mlmdc/Flexion-XS/3_Conception_Mécanique/0_LISEZ_MOI.md

# Conception mécanique

Ce répertoire contient :

* /"Impression 3D" contient les fichiers .stl réalisés, par exemple le support d'acceleromètre.

* /"LETTRE 7 ET 8" contient les .CATPart (sans assemblage) des lettres 7 & 8 utilisées pour le nouveau balisage.

* / a l'assemblage de la maquette ainsi que les parties utilisées. En parallèle, la caractérisation du moteur et de son filtre est donné.

Un pdf d'explications vis-à-vis du procédé de conception est donné.
