mlmdc/Flexion-XS/2_Conception_électronique/0_LISEZ_MOI.md

# Conception électronique

Ce dossier contient le travail effectué sur la conception électronique ajoutée au projet. 
Cela correspond à 2 parties :
* La remise au gout du jour et de la réalité du schéma de sécurité EDITSAB
* La conception de la carte filtre passe-bas

A ces 2 taches sont ajoutés des rapports d'activités expliquant le processus de conception.
