mlmdc/Flexion-XS/0_Documents/0_LISEZ_MOI.md

# Documents

**/Documents** contient les documents comme le tutoriel et autres. La source des documents (en .md) ainsi que les images utilisées sont aussi fournies, dans le but de pouvoir modifier les documents pendant les autres semestres.

**/Sources** contient les sources des documents de Tutoriel.pdf et Perspectives.pdf, ainsi que les images sources utilisées pour agrémenter visuellement les documents.
Si vous souhaitez produire un document, mettez vous dans ce répertoire et générez par commande les .pdf.
L'idée de séparer le produit d'arrivée de sa source est pour ne pas mélanger les travaux déjà effectués de ceux qui n'ont pas été encore effectués.
