mlmdc/Flexion-XS/4_Medias/0_LISEZ_MOI.md

# Medias

Ce répertoire contient les médias photos et vidéos qui vous permettront de vous situer et de comprendre le projet.

**/Photos**, comme son nom l'indique, est le lieu de toutes les photos. Celles-ci vont de l'illustration de diaporama à des photos de la maquette.

**/Videos** est lui pour les vidéos tutoriels.
