mlmdc/Flexion-XS/5_Post-traitements/0_LISEZ_MOI.md

### Post-traitements

**/Post-traitements** contient les notebooks de post-traitements, avec un rangement par type de mesures.
Au lieu de versionnage par git, le versionnage est fait en copiant les documents et en les modifiant.
L'objectif est de garder les précedentes modifications pour réutilisations ultérieures.
