mlmdc/Flexion-XS/0_Documents/affiche_flexion.pdf

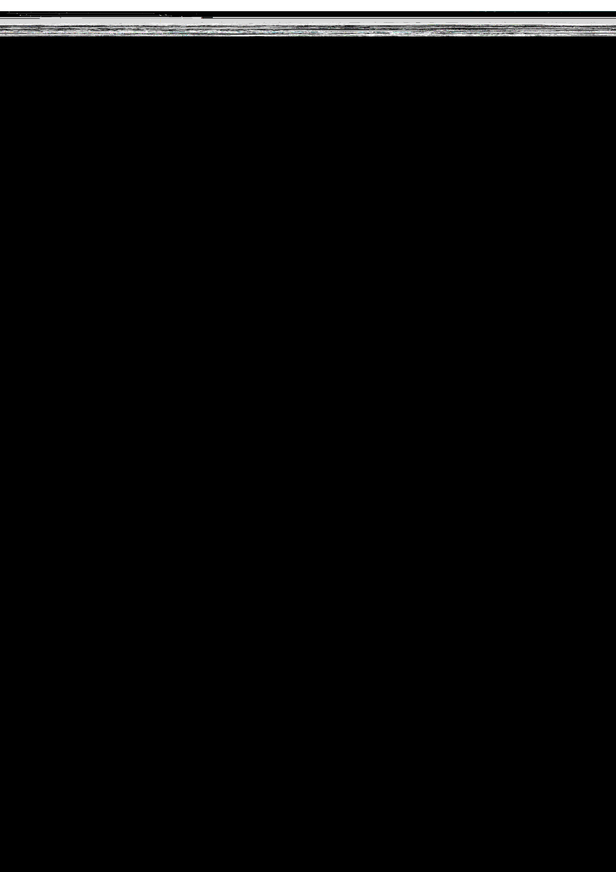
[picture p45: page 1]
