mlmdc/Flexion-XS/2_Conception_électronique/Filtre Passe-bas/Illustration exemple.PNG

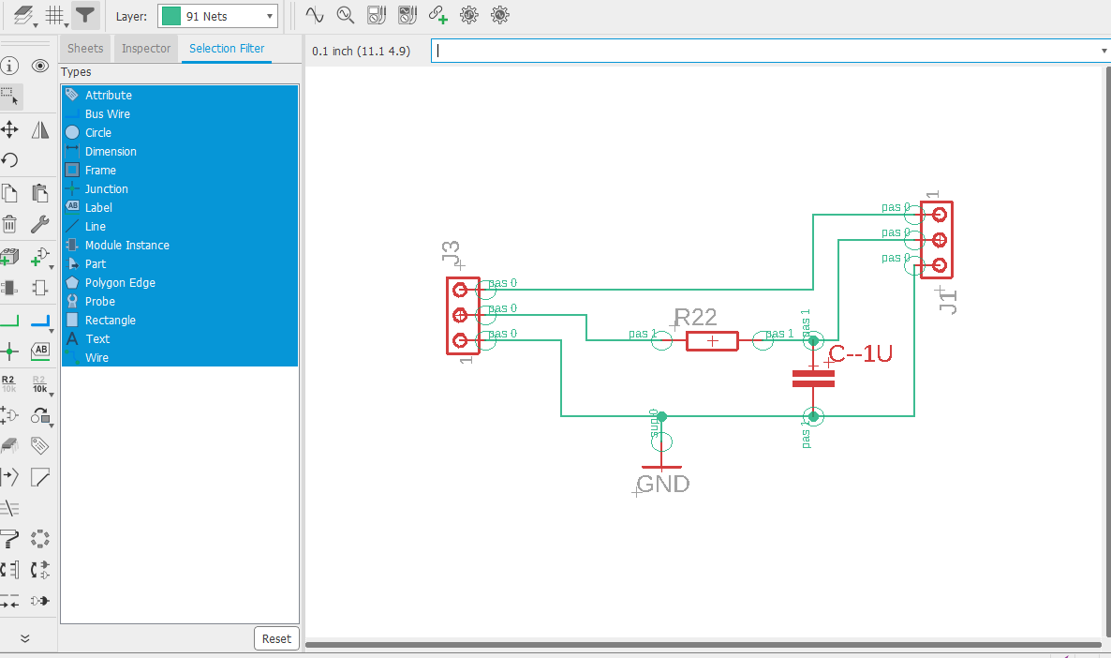
2_Conception_électronique/Filtre Passe-bas/Illustration exemple.PNG
