mlmdc/Flexion-XS/4_Medias/Photos/branchement_accel.jpg

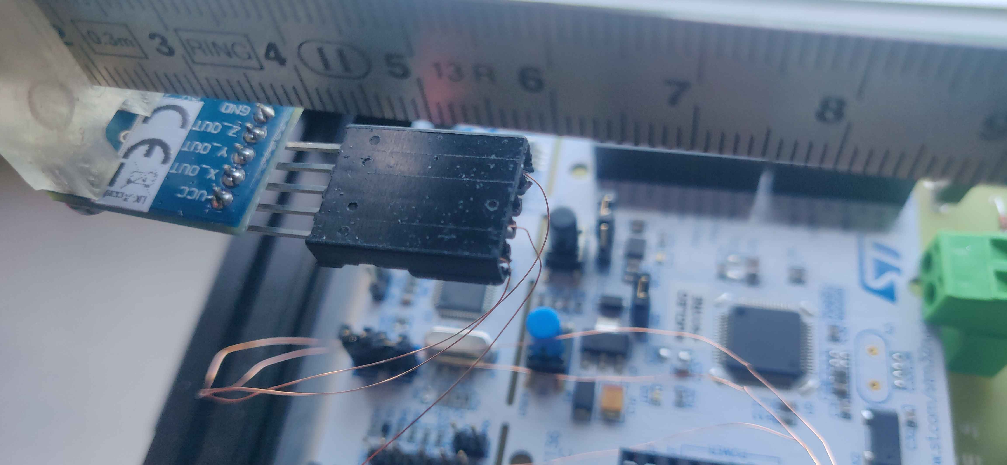
4_Medias/Photos/branchement_accel.jpg
