mlmdc/Flexion-XS/4_Medias/Photos/cablage_aimant_relais.jpg

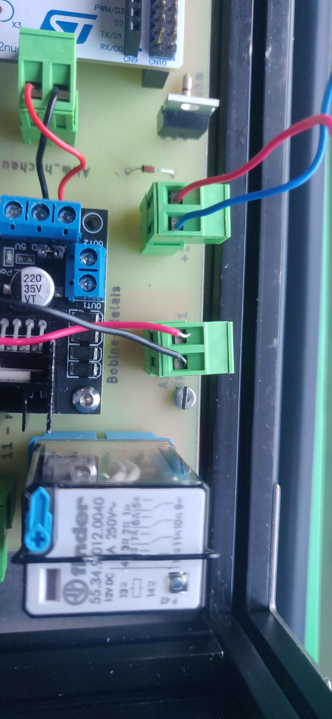
4_Medias/Photos/cablage_aimant_relais.jpg
