mlmdc/Flexion-XS/4_Medias/Photos/cablage_filtre_accel.jpg

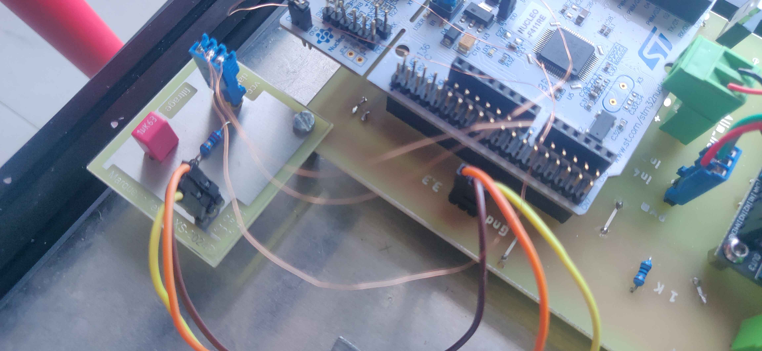
4_Medias/Photos/cablage_filtre_accel.jpg
