mlmdc/Flexion-XS/4_Medias/Photos/cablage_kas.jpg

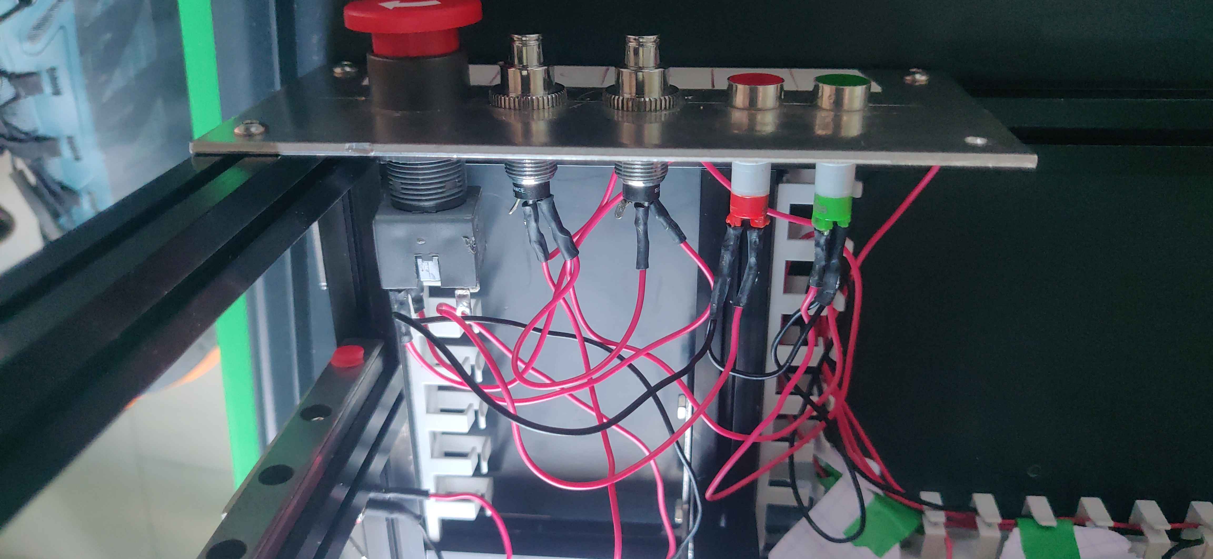
4_Medias/Photos/cablage_kas.jpg
