mlmdc/Flexion-XS/4_Medias/Photos/cablage_moteur_hacheur.jpg

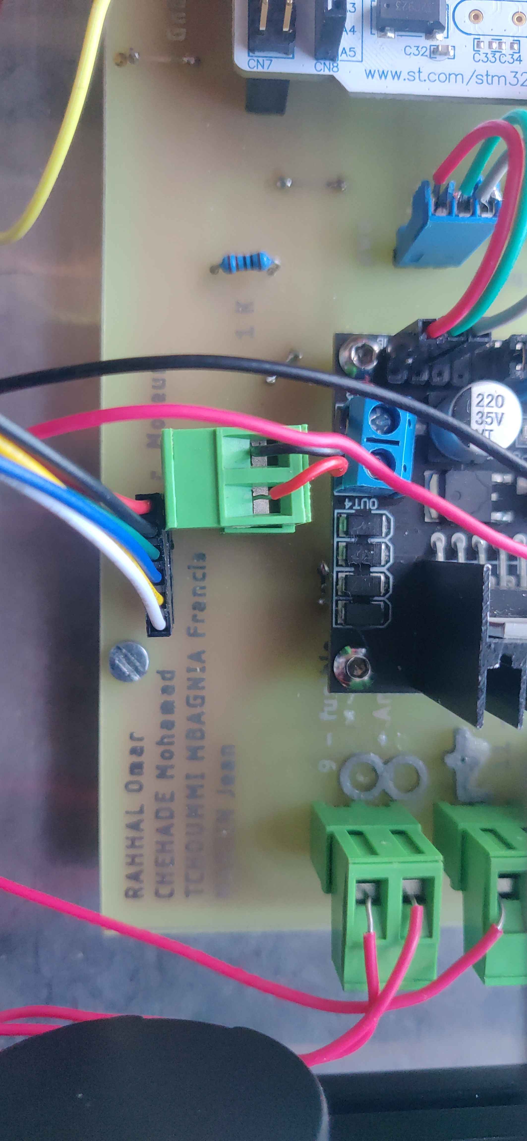
4_Medias/Photos/cablage_moteur_hacheur.jpg
