mlmdc/Flexion-XS/4_Medias/Photos/cablage_pwm_dir.jpg

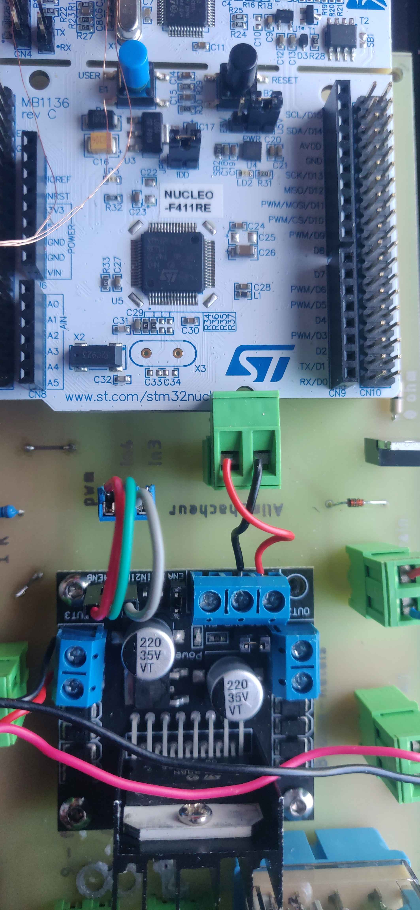
4_Medias/Photos/cablage_pwm_dir.jpg
