mlmdc/Flexion-XS/4_Medias/Photos/cablage_relais_alim.jpg

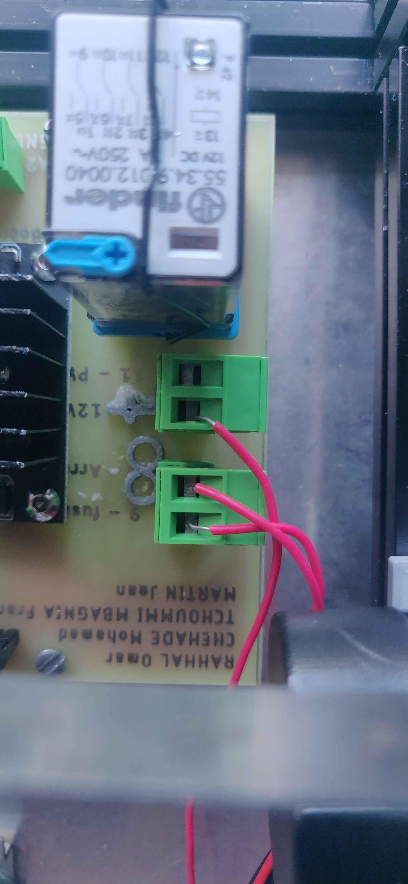
4_Medias/Photos/cablage_relais_alim.jpg
