mlmdc/Flexion-XS/4_Medias/Photos/datasheet_adxl335.png

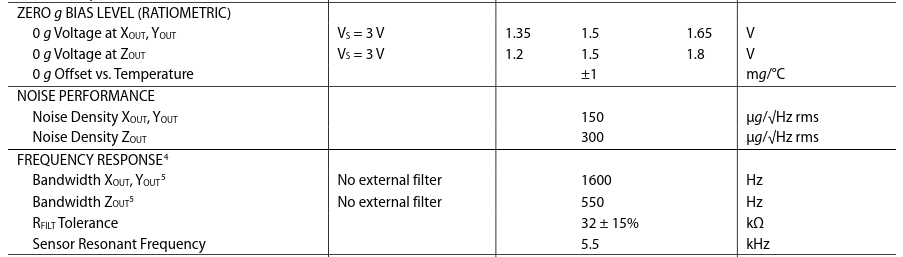
4_Medias/Photos/datasheet_adxl335.png
