mlmdc/Flexion-XS/4_Medias/Photos/exemple_lecture_simple.png

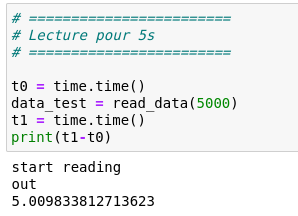
4_Medias/Photos/exemple_lecture_simple.png
