mlmdc/Flexion-XS/4_Medias/Photos/filtre.jpg

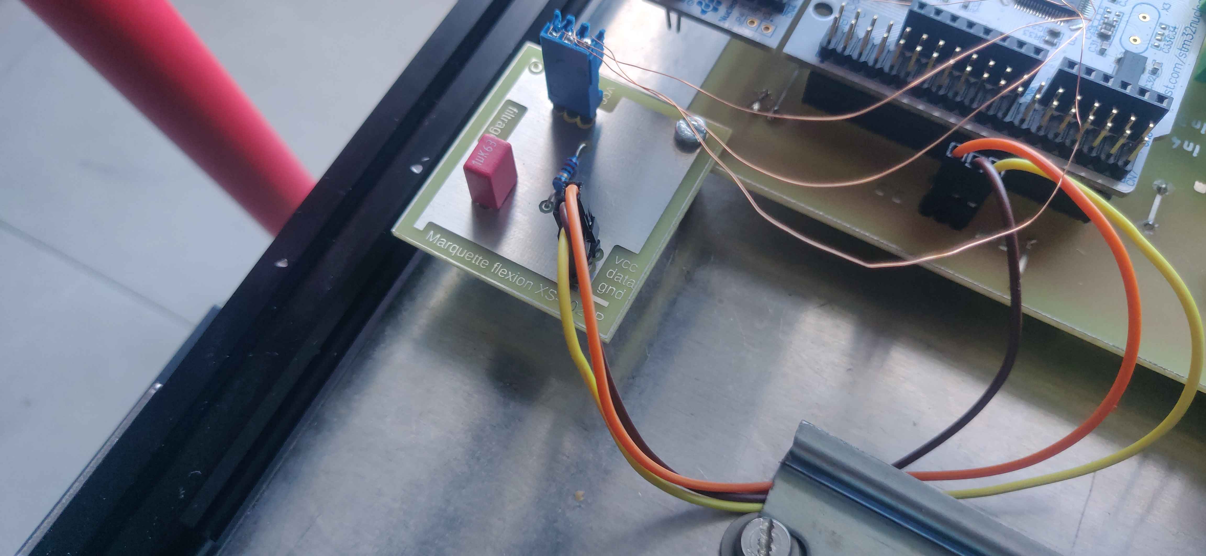
4_Medias/Photos/filtre.jpg
