mlmdc/Flexion-XS/4_Medias/Photos/illust_reduction_bruit_savgol.png

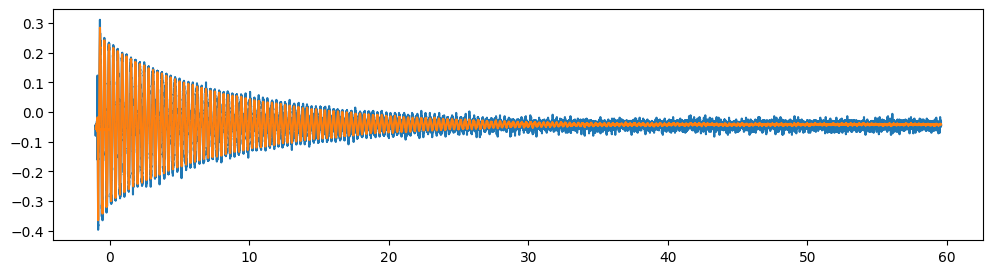
4_Medias/Photos/illust_reduction_bruit_savgol.png
