mlmdc/Flexion-XS/4_Medias/Photos/maquette_vierge.png

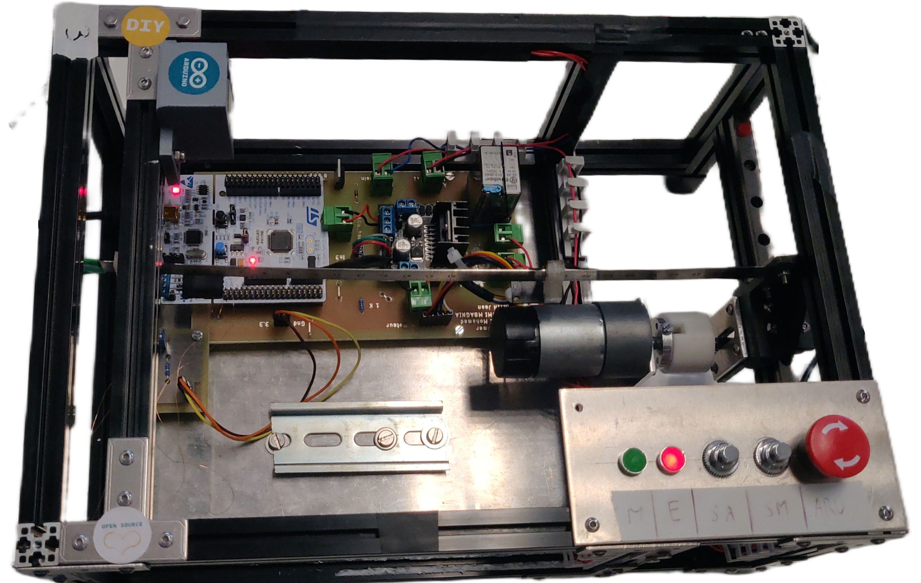
4_Medias/Photos/maquette_vierge.png
