mlmdc/Flexion-XS/4_Medias/Photos/matrix_rain_reglette.png

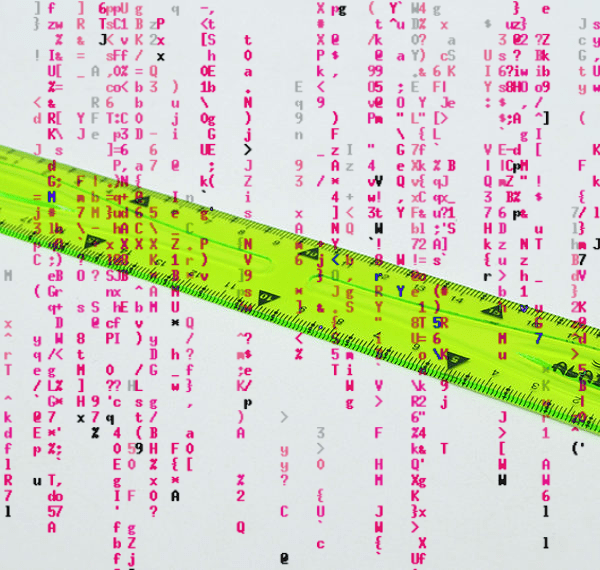
4_Medias/Photos/matrix_rain_reglette.png
