mlmdc/Flexion-XS/4_Medias/Photos/mesure_moteur_pololu37D.png

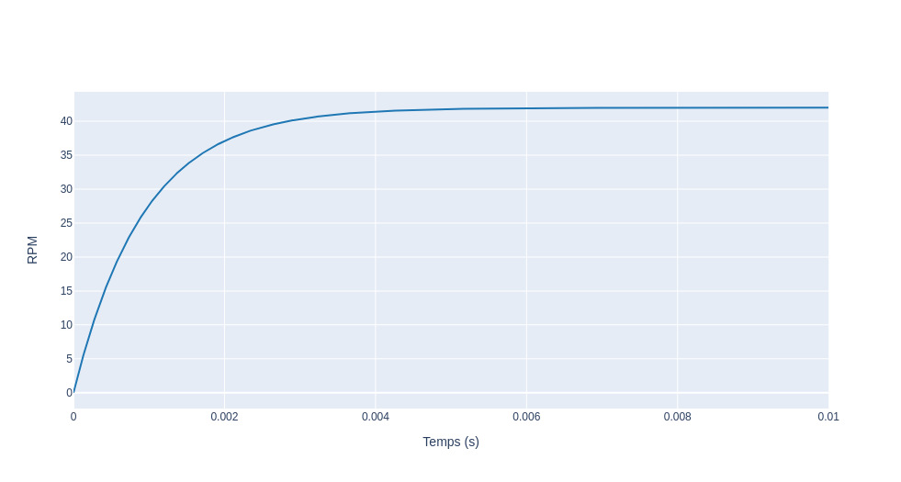
4_Medias/Photos/mesure_moteur_pololu37D.png
