mlmdc/Flexion-XS/4_Medias/Photos/mesure_p2.png

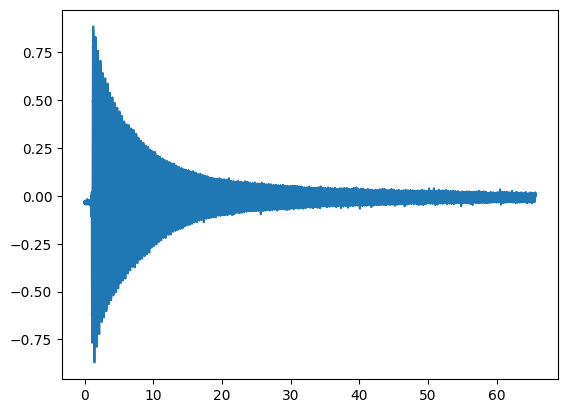
4_Medias/Photos/mesure_p2.png
