mlmdc/Flexion-XS/4_Medias/Photos/mesure_p3.png

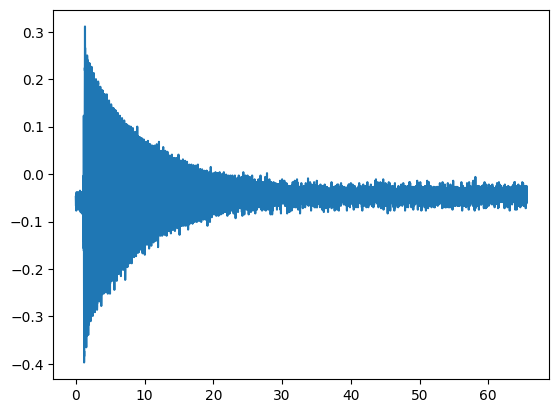
4_Medias/Photos/mesure_p3.png
