mlmdc/Flexion-XS/4_Medias/Photos/peak_frf2_2031.png

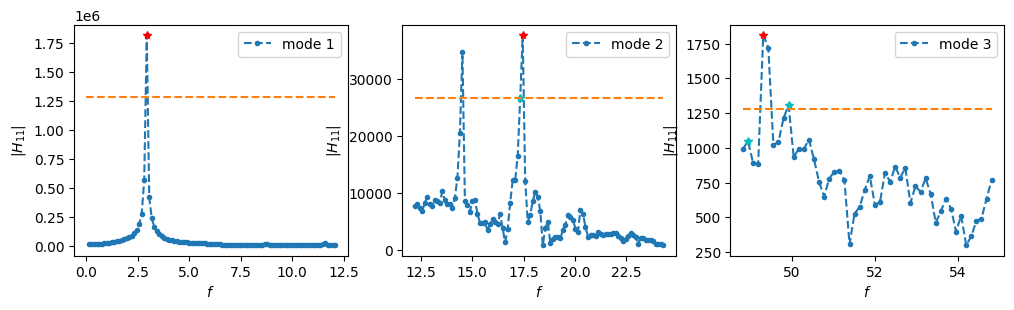
4_Medias/Photos/peak_frf2_2031.png
