mlmdc/Flexion-XS/4_Medias/Photos/peak_frf3_2031.png

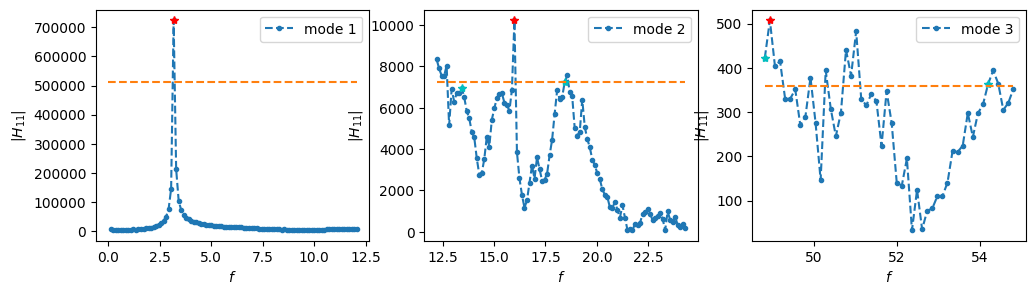
4_Medias/Photos/peak_frf3_2031.png
