mlmdc/Flexion-XS/4_Medias/Photos/plot_pid.png

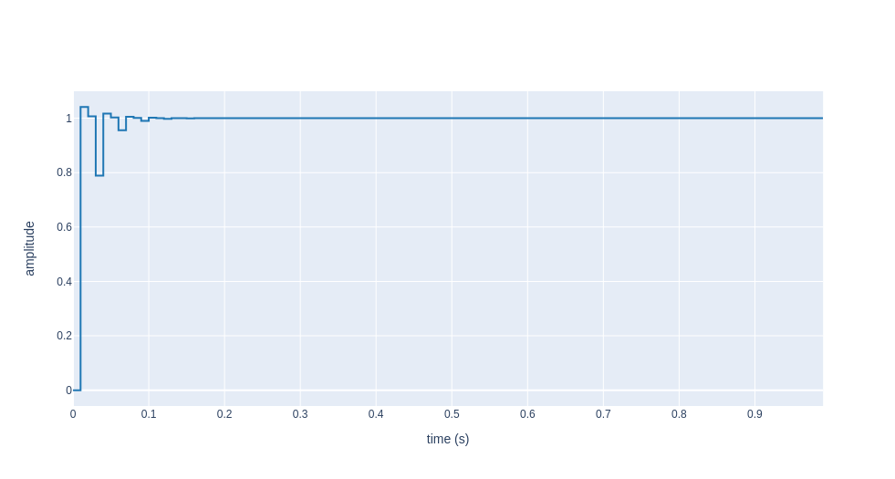
4_Medias/Photos/plot_pid.png
