mlmdc/Flexion-XS/4_Medias/Photos/projet_ips.png

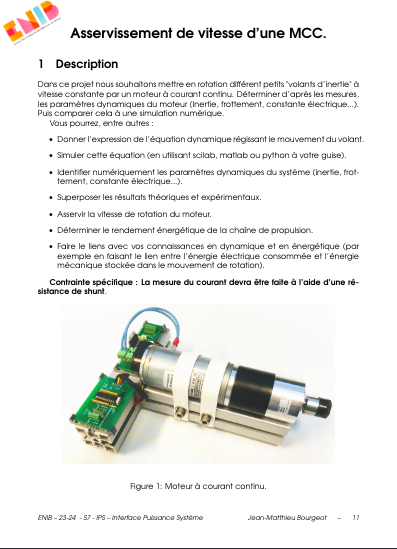
4_Medias/Photos/projet_ips.png
