mlmdc/Flexion-XS/3_Conception_Mécanique/Impression 3D/entraxe_sans_reducteur.stl

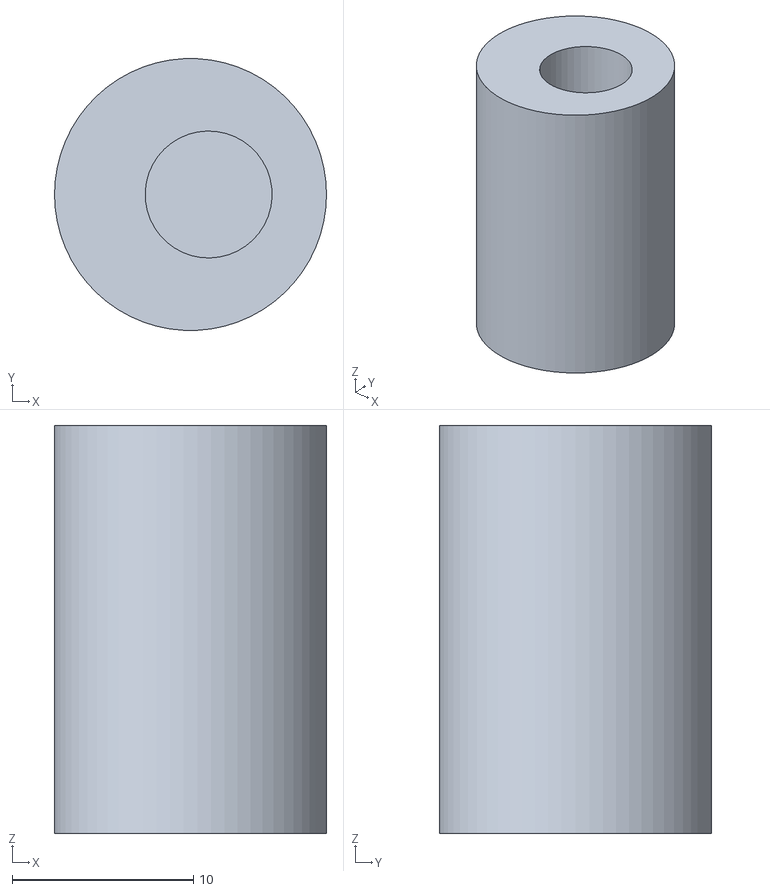
[picture p68: CAD file, 2026-10-20]
3_Conception_Mécanique/Impression 3D/entraxe_sans_reducteur.stl
15.0 x 15.0 x 22.5
