mlmdc/Flexion-XS/3_Conception_Mécanique/Impression 3D/Support_Accelero.stl

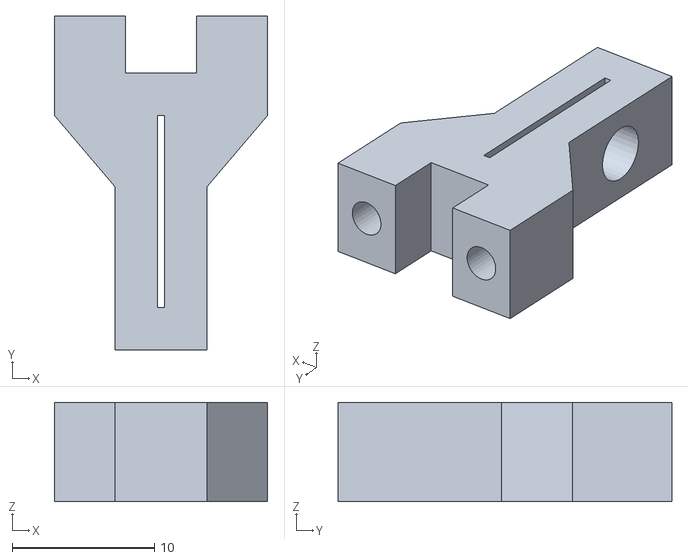
[picture p69: CAD file, 2026-10-20]
3_Conception_Mécanique/Impression 3D/Support_Accelero.stl
15.0 x 23.5 x 7.00
