mlmdc/Flexion-XS/(list of files, cad)

Other CAD files:
3_Conception_Mécanique/ACCOUPLEMENT.CATPart
3_Conception_Mécanique/HEXCENTRICITE.CATPart
3_Conception_Mécanique/LETTRE 7 ET 8/7.CATPart
3_Conception_Mécanique/LETTRE 7 ET 8/8.CATPart
3_Conception_Mécanique/TIGE.CATPart
3_Conception_Mécanique/Vis_v2.CATPart
3_Conception_Mécanique/assemblage excentrique.CATProduct
3_Conception_Mécanique/le moteur.CATPart
