mlmdc/Flexion-XS/4_Medias/Photos/montage_complet_vue_haut.jpg

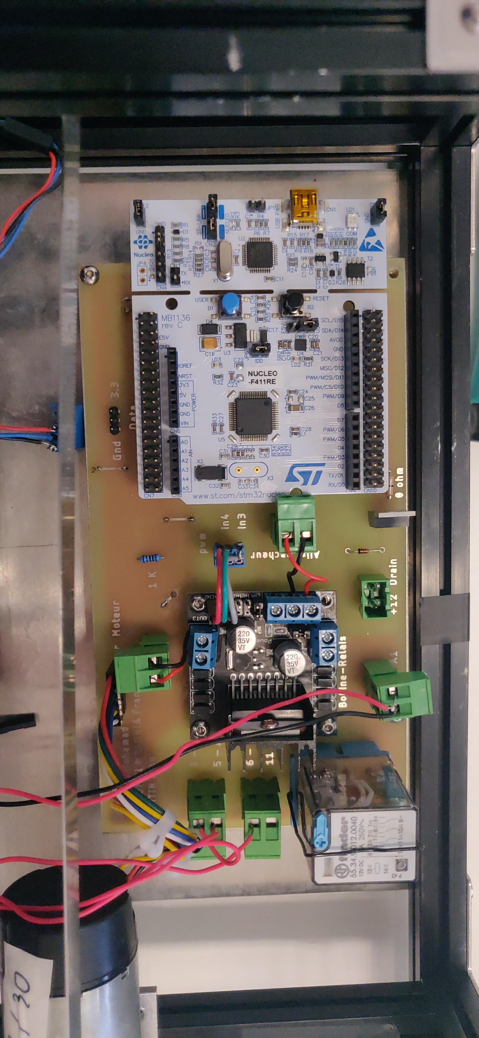
4_Medias/Photos/montage_complet_vue_haut.jpg
