mlmdc/Flexion-XS/4_Medias/Photos/montage_moteur_sans_reducteur.jpg

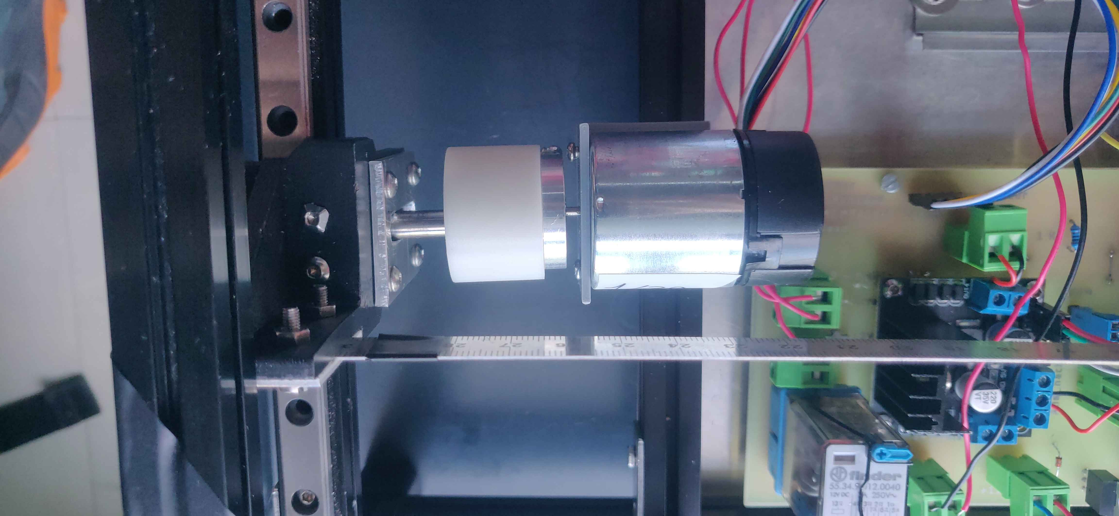
4_Medias/Photos/montage_moteur_sans_reducteur.jpg
