mlmdc/Flexion-XS/4_Medias/Photos/montage_vierge.jpg

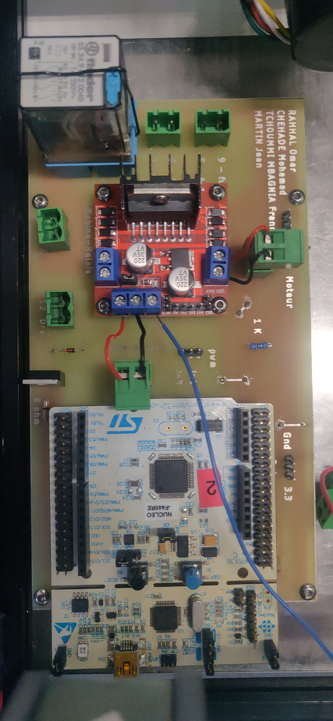
4_Medias/Photos/montage_vierge.jpg
