mlmdc/Flexion-XS/Measurements/0_LISEZ_MOI.md

# Measurements

Le dossier **/Measurements** est destiné au partage entre notebooks des mesures.
**Ne pas modifier le nom du dossier sans prendre en compte la modification dans le code**.
**Ne pas supprimer le répertoire si vous souhaitez faire du post-traitement**.
