mlmdc/Flexion-XS/4_Medias/Photos/article-outils-resolution-de-probleme-1.png

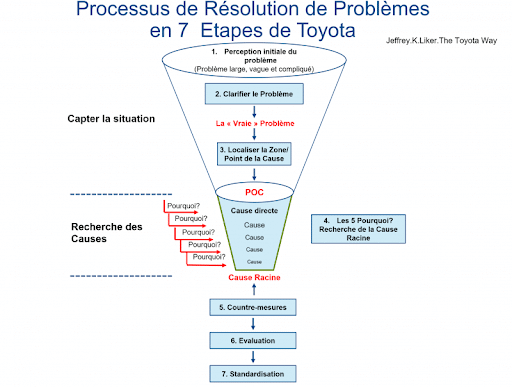
4_Medias/Photos/article-outils-resolution-de-probleme-1.png
