mlmdc/Flexion-XS/2_Conception_électronique/Filtre Passe-bas/Schema passe-bas.brd

## EAGLE design 2_Conception_électronique/Filtre Passe-bas/Schema passe-bas.brd (2026-10-20)

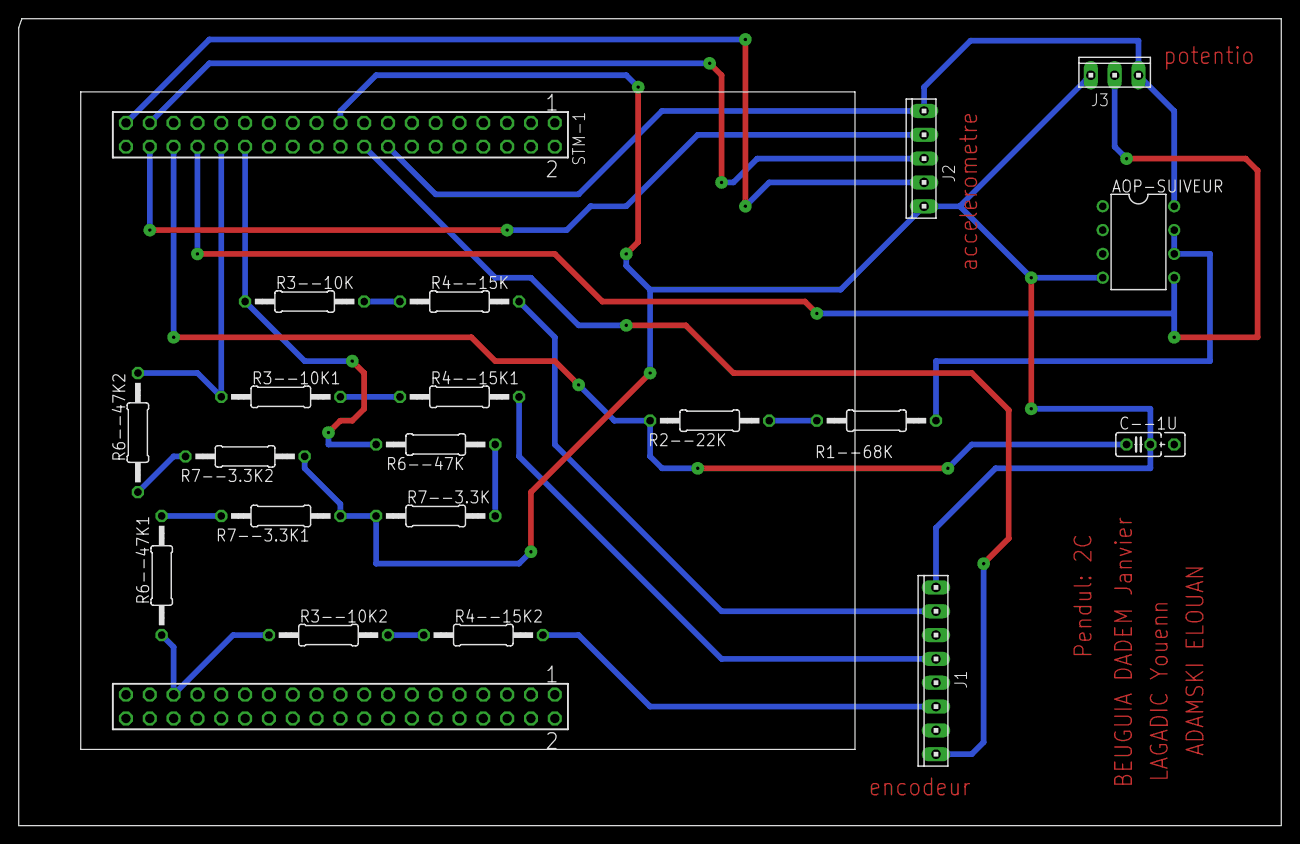
[picture p74: board Schema passe-bas.brd from above]

Board: 2 copper layers, 134.6 x 86.0 mm, 20 parts (0 on the bottom side), 22 nets.

Parts:
AOP-SUIVEUR: TL082P; DIL08
C--1U: C025_050-025X075
J1: 10X08MTA
J2: 10X05MTA
J3: 10X03MTA
R1--68K, R2--22K, R3--10K, R3--10K1, R3--10K2, R4--15K, R4--15K1, R4--15K2, R6--47K, R6--47K1, R6--47K2, R7--3.3K, R7--3.3K1, R7--3.3K2: 0207/12
STM-1: NUCLEO-F411RE; CONN_STM32_NUCLEO

Connections:
GND: AOP-SUIVEUR.4, C--1U.2, J1.1, J2.5, J3.3, R7--3.3K.1, R7--3.3K1.1, R7--3.3K2.1, STM-1.19
unnamed: R1--68K.2, R2--22K.1
unnamed: AOP-SUIVEUR.6, AOP-SUIVEUR.7, R1--68K.1
unnamed: R3--10K2.1, R6--47K1.1, STM-1.71
unnamed: AOP-SUIVEUR.5, J3.2, STM-1.32
unnamed: R6--47K.1, R7--3.3K.2
unnamed: J1.2, R4--15K.2
unnamed: R3--10K.2, R4--15K.1
unnamed: R6--47K1.2, R7--3.3K1.2
unnamed: R3--10K.1, R6--47K.2, STM-1.28
unnamed: J1.4, R4--15K1.2
unnamed: AOP-SUIVEUR.8, J2.1, J3.1, STM-1.16
unnamed: R3--10K1.2, R4--15K1.1
unnamed: R6--47K2.1, R7--3.3K2.2
unnamed: R3--10K1.1, R6--47K2.2, STM-1.30
unnamed: J1.6, R4--15K2.2
unnamed: R3--10K2.2, R4--15K2.1
unnamed: C--1U.1, R2--22K.2, STM-1.34
unnamed: J2.4, STM-1.37
unnamed: J2.3, STM-1.35
unnamed: J2.2, STM-1.36
VCC: J1.8, STM-1.18
