mlmdc/Flexion-XS/REGLETTE_CMV/Core/Src/main.c

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
/* Includes ------------------------------------------------------------------*/
#include "main.h"
#include "adc.h"
#include "dma.h"
#include "tim.h"
#include "usart.h"
#include "gpio.h"

/* USER CODE BEGIN Includes */
#include "comm.h"
#include "accelerometer.h"
#include "pwmCommand.h"
#include "mccCommand.h"
#include "pidFilter.h"
#include "speed.h"
#include "tickTimer.h"
/* USER CODE END Includes */


/* USER CODE BEGIN PV */

volatile uint32_t ms_value = 0;
unsigned char rx_data[16];
char ident_data[5];
char value_data[13];

uint32_t test_t0, test_t1;

/* USER CODE END PV */

void SystemClock_Config(void);
/* USER CODE BEGIN PFP */
#ifdef __GNUC__
#define PUTCHAR_PROTOTYPE int __io_putchar(int ch)
#else
#define PUTCHAR_PROTOTYPE int fputc(int ch, FILE *f)
#endif

PUTCHAR_PROTOTYPE
{
	HAL_UART_Transmit(&huart2, (uint8_t *)&ch, 1, HAL_MAX_DELAY); //FOR DELAY
	return ch;
}
/* USER CODE END PFP */

/**
  * @brief  The application entry point.
  * @retval int
  */
int main(void)
{
  /* MCU Configuration--------------------------------------------------------*/

  /* Reset of all peripherals, Initializes the Flash interface and the Systick. */
  HAL_Init();

  /* Configure the system clock */
  SystemClock_Config();

  /* Initialize all configured peripherals */
  MX_GPIO_Init();
  MX_DMA_Init();
  MX_USART2_UART_Init();
  MX_ADC1_Init();
  MX_TIM2_Init();
  MX_TIM3_Init();
  MX_TIM11_Init();
  MX_TIM4_Init();
  /* USER CODE BEGIN 2 */
  HAL_TIM_Base_Start(&htim11);

  //INIT PERSOS
  pwm_Init();
  pwm_SetDuty(0.0f);


  /* ENCODER SPEED Init */
  encoder_Init();


  /* MCC Set Direction */
  mcc_SetCCW();
  mcc_SetMagnet(0);

  /* PID Init */
  pidFilter_Init();
  //pidFilter_SetFrequency(6.0f);
  pidFilter_SetCommand(180.0f);

  /* DMA ADC INIT*/
  acc_Init();
  HAL_Delay(100);

  /* USART RECEPTION */
  HAL_UART_Receive_IT(&huart2, rx_data, 16);

  HAL_Delay(100);

  /* TIM2 Global interruptions */
  tickTimer_Init(1); // period in ms

  //tickTimer_Start();
  /* Initial tickTime */
  /* USER CODE END 2 */

  /* Infinite loop */
  /* USER CODE BEGIN WHILE */
  while (1)
  {
    /* USER CODE END WHILE */

    /* USER CODE BEGIN 3 */
  }
  /* USER CODE END 3 */
}

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
/* USER CODE BEGIN 4 */

//====================================================================
//			TIMER CALLBACK PERIOD
//====================================================================

void HAL_TIM_PeriodElapsedCallback(TIM_HandleTypeDef *htim)
{
	if (htim->Instance == TIM2){
	//====================================================================
	//			ms count
	//====================================================================
	ms_value++; //= HAL_GetTick();
	acc_StartDMA();
	/*
	 * Protocole données :
	 * 1. Récupération des données
	 * 		ADC
	 * 		Valeur tr/min
	 *
	 * 2. Traitement des données (optionnel)
	 * 		Si données ne sont pas formalisées, traitement
	 *
	 * 3. Préparation données à l'envoi
	 *
	 * 4. Envoi des données
	 */

	//mcc_SetMagnet(1);

	//printf("MOTOR SPEED %f \n\r", output_speed);
	//printf("PWM_Value %i \n\r", (int)PWM_Value);

	//====================================================================
	//			PID Filter
	//====================================================================
	// Constante de temps mécanique tm : 13ms
	// Stabilisation du moteur après sa commande : 5*tm
	if ((ms_value % 1) == 0)
	{
		//encoder_GetSpeed();

		acc_GetValue();

		acc_Voltage2Accel();

		comm_SendData(ms_value);

	}

	//====================================================================
	//			ms_count reset
	//====================================================================
	if ((ms_value % 10) == 0)
	{
		//pidFilter_Compute();
		encoder_GetSpeed();
		pidFilter_Compute();
	}
	//mcc_SetMagnet(0);
	acc_StopDMA();
}
}

void HAL_UART_RxCpltCallback(UART_HandleTypeDef *huart)
{
	/* Decoupage données */
	comm_SliceInput((char *)rx_data, ident_data, value_data);

	/* Traitement données */
	comm_ComputeInput(ident_data, value_data);

	memset(rx_data, 0, sizeof(rx_data)); //reset des données
	/* Réarmement réception */
	HAL_UART_Receive_IT(&huart2, rx_data, 16);
}

/* USER CODE END 4 */
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
