mlmdc/Flexion-XS/REGLETTE_CMV/REGLETTE_CMV.ioc

Mcu.UserName=STM32F411RETx
PA0-WKUP.Signal=ADCx_IN0
PA11.Signal=GPIO_Output
PA12.Signal=GPXTI12
PA13.GPIO_Label=TMS
PA13.Signal=SYS_JTMS-SWDIO
PA14.GPIO_Label=TCK
PA14.Signal=SYS_JTCK-SWCLK
PA2.GPIO_Label=USART_TX
PA2.Signal=USART2_TX
PA3.GPIO_Label=USART_RX
PA3.Signal=USART2_RX
PA5.Signal=GPIO_Output
PA8.Signal=GPIO_Output
PA9.Signal=GPIO_Output
PB5.Signal=GPIO_Output
PB6.Signal=S_TIM4_CH1
PB7.Signal=S_TIM4_CH2
PB9.Signal=S_TIM11_CH1
PC13-ANTI_TAMP.Signal=GPIO_Input
PC14-OSC32_IN.Signal=RCC_OSC32_IN
PC15-OSC32_OUT.Signal=RCC_OSC32_OUT
PC7.Signal=GPXTI7
