mlmdc/Flexion-XS/REGLETTE_CMV/Core/Inc/speed.h

/*
 * speed.h
 *
 *  Created on: Mar 20, 2024
 *      Author: Madec
 */

#ifndef INC_SPEED_H_
#define INC_SPEED_H_

#include "main.h"

extern volatile float output_speed;
extern volatile int32_t Nindex;

void encoder_Init(void);

uint16_t encoder_FetchPosition();
void encoder_UpdatePosition();

void encoder_GetSpeed();

void encoder_SpeedUpdate(float* source, float new_speed);

float encoder_EWMAverage(float* source, float alpha);

void encoder_CallbackIndex();

#endif /* INC_SPEED_H_ */

//============================================
//			TIMER 1 ENCODER CONFIG
//============================================

/*
TIM_HandleTypeDef htim1;

void MX_TIM1_Init(void)
{

  TIM_Encoder_InitTypeDef sConfig = {0};
  TIM_MasterConfigTypeDef sMasterConfig = {0};

  htim1.Instance = TIM1;
  htim1.Init.Prescaler = 0;
  htim1.Init.CounterMode = TIM_COUNTERMODE_UP;
  htim1.Init.Period = 4000;
  htim1.Init.ClockDivision = TIM_CLOCKDIVISION_DIV1;
  htim1.Init.RepetitionCounter = 0;
  htim1.Init.AutoReloadPreload = TIM_AUTORELOAD_PRELOAD_ENABLE;
  sConfig.EncoderMode = TIM_ENCODERMODE_TI12;
  sConfig.IC1Polarity = TIM_ICPOLARITY_RISING;
  sConfig.IC1Selection = TIM_ICSELECTION_DIRECTTI;
  sConfig.IC1Prescaler = TIM_ICPSC_DIV4;
  sConfig.IC1Filter = 10;
  sConfig.IC2Polarity = TIM_ICPOLARITY_RISING;
  sConfig.IC2Selection = TIM_ICSELECTION_DIRECTTI;
  sConfig.IC2Prescaler = TIM_ICPSC_DIV4;
  sConfig.IC2Filter = 10;
  if (HAL_TIM_Encoder_Init(&htim1, &sConfig) != HAL_OK)
  {
    Error_Handler();
  }
  sMasterConfig.MasterOutputTrigger = TIM_TRGO_RESET;
  sMasterConfig.MasterSlaveMode = TIM_MASTERSLAVEMODE_DISABLE;
  if (HAL_TIMEx_MasterConfigSynchronization(&htim1, &sMasterConfig) != HAL_OK)
  {
    Error_Handler();
  }
}
*/
