mlmdc/Flexion-XS/REGLETTE_CMV/Core/Inc/tickTimer.h

/*
 * tickTimer.h
 *
 *  Created on: 31 mars 2016
 *      Author: kerhoas
 */

#ifndef INC_TICKTIMER_H_
#define INC_TICKTIMER_H_


#include "main.h"

void tickTimer_Init(int);

void tickTimer_Start(void);

void tickTimer_Stop(void);

#endif /* INC_TICKTIMER_H_ */

/* TIM2 init function
void MX_TIM2_Init(void)
{



  TIM_ClockConfigTypeDef sClockSourceConfig = {0};
  TIM_MasterConfigTypeDef sMasterConfig = {0};

  htim2.Instance = TIM2;
  htim2.Init.Prescaler = 0;
  htim2.Init.CounterMode = TIM_COUNTERMODE_UP;
  htim2.Init.Period = 4294967295;
  htim2.Init.ClockDivision = TIM_CLOCKDIVISION_DIV1;
  htim2.Init.AutoReloadPreload = TIM_AUTORELOAD_PRELOAD_DISABLE;
  if (HAL_TIM_Base_Init(&htim2) != HAL_OK)
  {
    Error_Handler();
  }
  sClockSourceConfig.ClockSource = TIM_CLOCKSOURCE_INTERNAL;
  if (HAL_TIM_ConfigClockSource(&htim2, &sClockSourceConfig) != HAL_OK)
  {
    Error_Handler();
  }
  sMasterConfig.MasterOutputTrigger = TIM_TRGO_RESET;
  sMasterConfig.MasterSlaveMode = TIM_MASTERSLAVEMODE_DISABLE;
  if (HAL_TIMEx_MasterConfigSynchronization(&htim2, &sMasterConfig) != HAL_OK)
  {
    Error_Handler();
  }

}
 */
